Sonosus/KosmicSuperspreader/README.md

View this project on [CADLAB.io](https://cadlab.io/project/24378). 

# Kosmic Superspreader
[][cc-by-sa]
hits (https://hits.deltapapa.io)

## About

This is a Kosmo format 'spread' module.
It takes a CV input and a Spread input.
The Spread input is:
* added to the CV input and sent to the + output.
* subtracted from the CV input and sent to the - output.
The CV input is also buffered and sent to the Buffer output - no multiples needed.

The Spread pot is used as an offset for the Spread input if a jack is plugged in, if not the Spread jack is normalled to ground.
The offset from the Spread pot swings between 0V and 12V.



* [Interactive BOM](https://htmlpreview.github.io/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)
* [Build notes/troubleshooting guide](Docs/BUILD.md)
* [Schematic](https://github.com/Sonosus/KosmicSuperspreader/blob/main/Docs/KosmicSuperspreader.pdf)
* [PCB Gerber files](https://github.com/Sonosus/KosmicSuperspreader/tree/main/PCB/Gerber)
* [PCB zipped Gerber files](https://github.com/Sonosus/KosmicSuperspreader/blob/main/PCB/Gerber.zip)
* [Panel Gerber files](https://github.com/Sonosus/KosmicSuperspreader/tree/main/Panel/Gerber)
* [Panel zipped Gerber files](https://github.com/Sonosus/KosmicSuperspreader/blob/main/Panel/Gerber/SpreaderPanel.zip)
* [Tindie listing](https://www.tindie.com/products/sonosus/kosmic-superspreader/)

There is an error on the silkscreen affecting some PCBs. 
For the v1.3 PCBs sold on Tindie, please see the build guide above.

This work is licensed under a
[Creative Commons Attribution-ShareAlike 4.0 International License][cc-by-sa].

[][cc-by-sa]

[cc-by-sa]: http://creativecommons.org/licenses/by-sa/4.0/
[cc-by-sa-image]: https://licensebuttons.net/l/by-sa/4.0/88x31.png
[cc-by-sa-shield]: https://img.shields.io/badge/License-CC%20BY--SA%204.0-lightgrey.svg

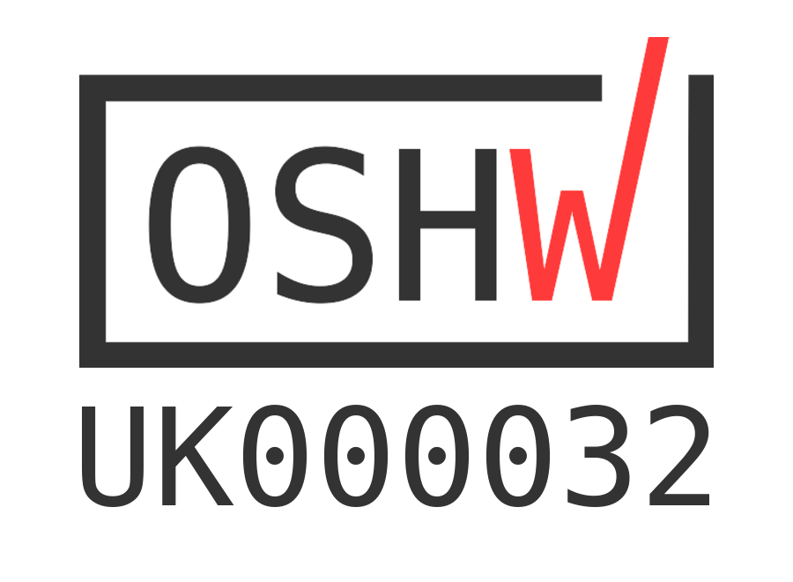
[picture p1: OSHW_mark_UK000032.png]


This project is certified [open source hardware](https://certification.oshwa.org/uk000032.html).
