Sonosus/KosmicSuperspreader/docs_site/docs/index.md

# Kosmic Superspreader

The Kosmic Superspreader is a CV processing module for detuning and offsetting control voltages in modular synthesizers.
