Sonosus/KosmicSuperspreader/Panel/Silkscreen/SpreaderPanel-brd.png

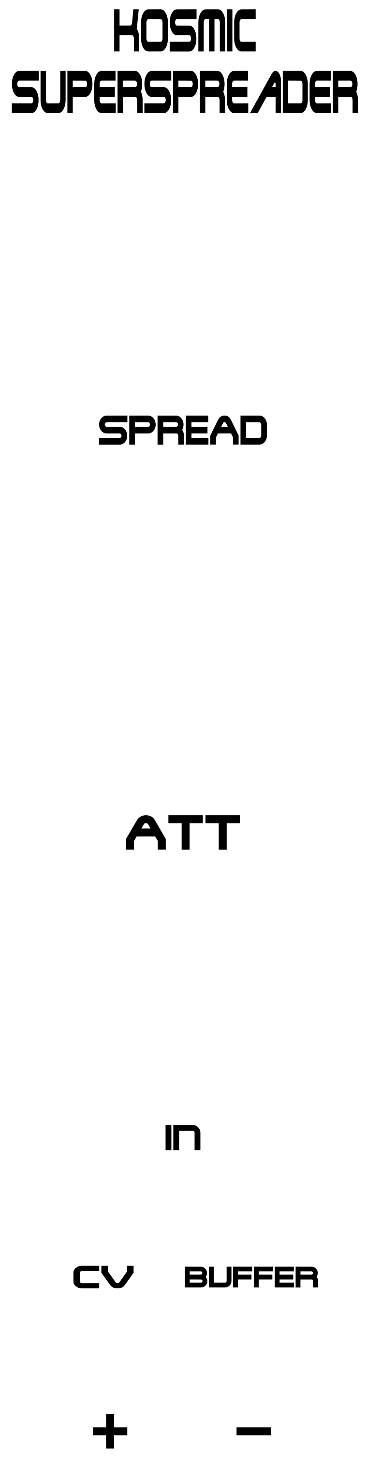
Panel/Silkscreen/SpreaderPanel-brd.png
