Sonosus/KosmicSuperspreader/Docs/KosmicSuperspreader.pdf

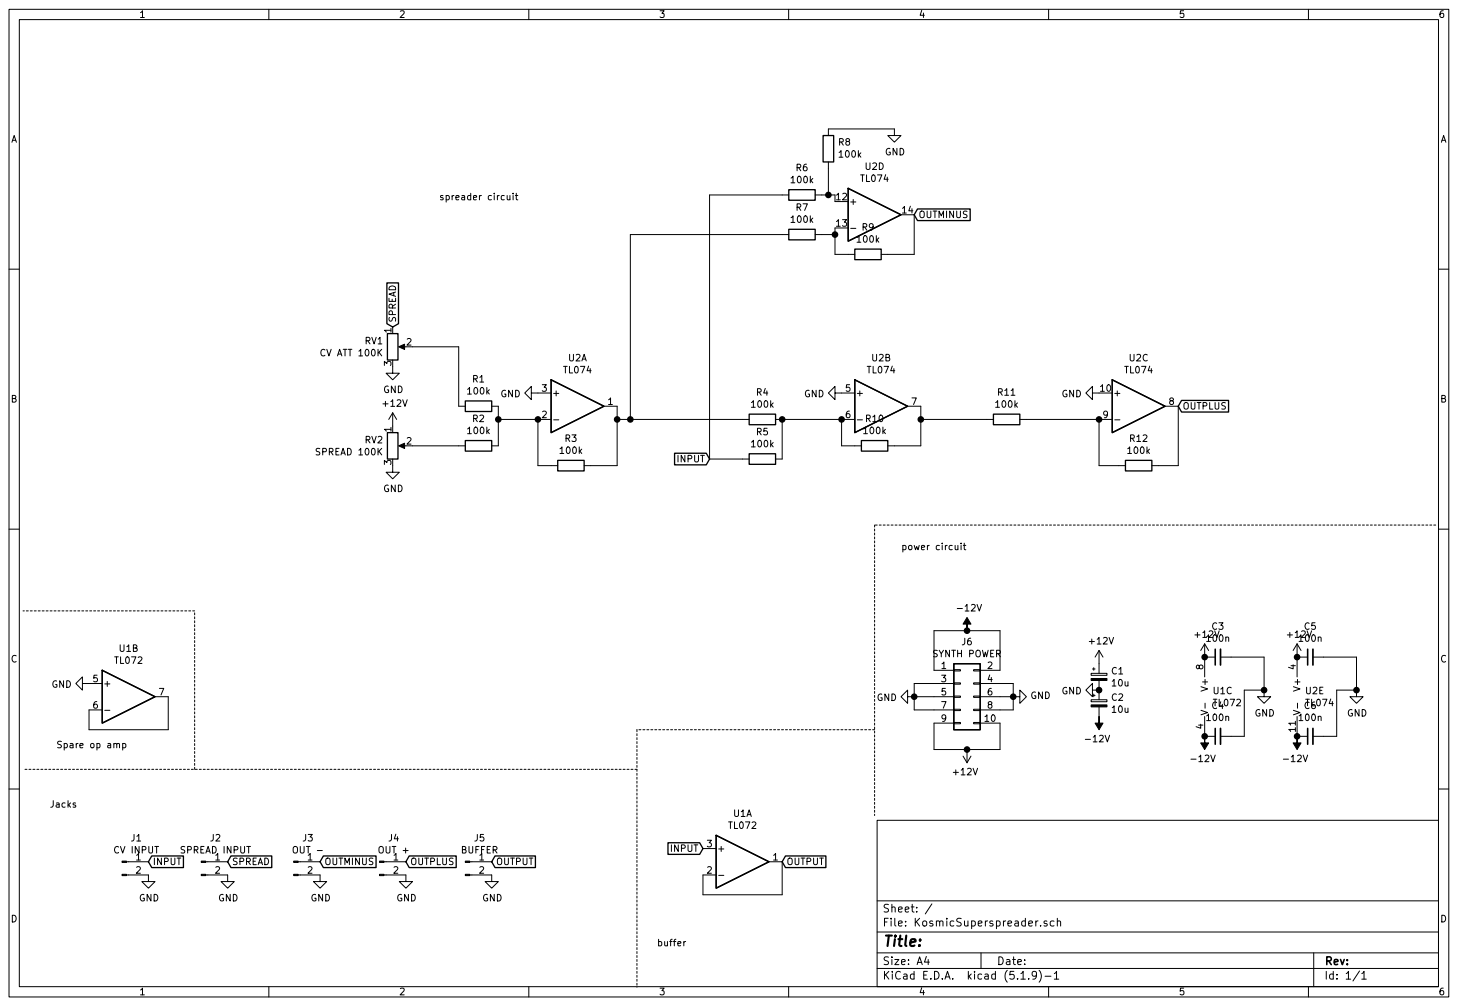
[picture p3: page 1]

File: KosmicSuperspreader.sch Sheet: / 1
