Sonosus/KosmicSuperspreader/(commit log)

2021-05-25 Create KiCAD project
    [KosmicSuperspreader.kicad_pcb, KosmicSuperspreader.sch]
2021-05-28 Add op amps
    [KosmicSuperspreader.sch]
2021-05-28 Add resistors
    [KosmicSuperspreader.sch]
2021-05-28 Jack labels
    [KosmicSuperspreader.sch]
2021-05-28 Pots and labels
    [KosmicSuperspreader.sch]
2021-05-28 Change jacks, fix labels
    [KosmicSuperspreader.sch]
2021-05-28 More decoupling
    [KosmicSuperspreader.sch]
2021-05-28 Clean up, add explanatory text, not tested
    [KosmicSuperspreader.sch]
2021-05-28 Assign footprints
    [KosmicSuperspreader.sch]
2021-05-28 Start pcb
    [KosmicSuperspreader.kicad_pcb]
2021-05-28 More pcb, to be continued
    [KosmicSuperspreader.kicad_pcb]
2021-05-29 Board outline, more rearranging
    [KosmicSuperspreader.kicad_pcb]
2021-05-29 Finish traces
    [KosmicSuperspreader.kicad_pcb]
2021-05-29 Pot labels
    [KosmicSuperspreader.kicad_pcb, KosmicSuperspreader.sch]
2021-05-29 ibom again
    [KosmicSuperspreader.kicad_pcb]
2021-05-29 text on silk
    [KosmicSuperspreader-B_Cu.gbr, KosmicSuperspreader-B_Mask.gbr, KosmicSuperspreader-B_SilkS.gbr, KosmicSuperspreader-Edge_Cuts.gbr, KosmicSuperspreader-F_Cu.gbr, KosmicSuperspreader-F_Mask.gbr, KosmicSuperspreader-F_SilkS.gbr, KosmicSuperspreader-job.gbrjob]
2021-05-30 shuffle components
    pots are now ~5cm apart
    [KosmicSuperspreader.kicad_pcb]
2021-05-30 start tracks
    [KosmicSuperspreader.kicad_pcb]
2021-05-30 -12 to gnd
    we dont need inverted behaviour
    [KosmicSuperspreader.sch]
2021-05-30 power n fills
    [KosmicSuperspreader.kicad_pcb]
2021-05-30 add pot values
    [KosmicSuperspreader.kicad_pcb, KosmicSuperspreader.sch]
2021-06-01 update bom
2021-06-01 pot alignment, labels not refs
    [KosmicSuperspreader.kicad_pcb]
2021-06-01 bom again
2021-06-01 1.3 gerb
    [KosmicSuperspreader-B_Cu.gbr, KosmicSuperspreader-B_Mask.gbr, KosmicSuperspreader-B_SilkS.gbr, KosmicSuperspreader-Edge_Cuts.gbr, KosmicSuperspreader-F_Cu.gbr, KosmicSuperspreader-F_Mask.gbr, KosmicSuperspreader-F_SilkS.gbr, KosmicSuperspreader-job.gbrjob]
2021-06-01 panel - no design yet...
    [KosmicSuperspreader.kicad_pcb, SpreaderPanel.kicad_pcb]
2021-06-01 quick organise
    [KosmicSuperspreader-B_Cu.gbr, KosmicSuperspreader-B_Mask.gbr, KosmicSuperspreader-B_SilkS.gbr, KosmicSuperspreader-Edge_Cuts.gbr, KosmicSuperspreader-F_Cu.gbr, KosmicSuperspreader-F_Mask.gbr, KosmicSuperspreader-F_SilkS.gbr, KosmicSuperspreader-job.gbrjob]
2021-06-01 sch pdf to docs
    [KosmicSuperspreader.sch]
2021-06-03 Add panel text
    [SpreaderPanel.kicad_pcb]
2021-06-03 Add JLC order no and licensing info
    [SpreaderPanel.kicad_pcb]
2021-06-03 panel gerbs
    [SpreaderPanel-B_Cu.gbr, SpreaderPanel-B_Mask.gbr, SpreaderPanel-B_SilkS.gbr, SpreaderPanel-Edge_Cuts.gbr, SpreaderPanel-F_Cu.gbr, SpreaderPanel-F_Mask.gbr, SpreaderPanel-F_SilkS.gbr, SpreaderPanel-job.gbrjob]
2021-09-24 add panel pcb image
2021-09-28 zipped gerbers
2021-09-28 zip again with version info
    [KosmicSuperspreader-B_Cu.gbr, KosmicSuperspreader-B_Mask.gbr, KosmicSuperspreader-B_SilkS.gbr, KosmicSuperspreader-Edge_Cuts.gbr, KosmicSuperspreader-F_Cu.gbr, KosmicSuperspreader-F_Mask.gbr, KosmicSuperspreader-F_SilkS.gbr, KosmicSuperspreader-NPTH.drl]
2021-12-10 sockets clarify
2021-12-10 rm redundant gerbers
    [KosmicSuperspreader-NPTH.drl, KosmicSuperspreader-PTH.drl]
